bo-zon/LM3886-Hi-Fi-amplifier/docs/intedratS_018-ldsound.ru-2.jpg

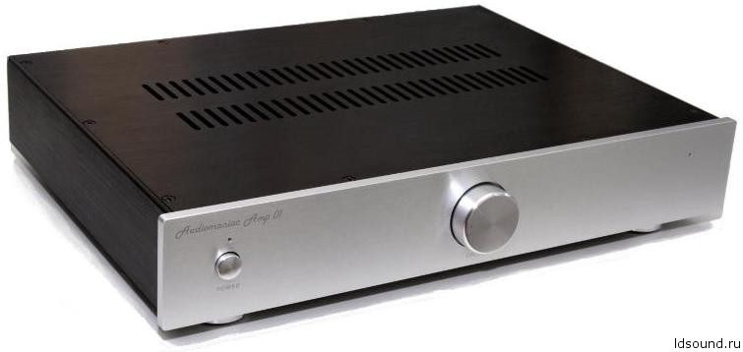
docs/intedratS_018-ldsound.ru-2.jpg
