bo-zon/LM3886-Hi-Fi-amplifier/docs/IMG_0611.jpg

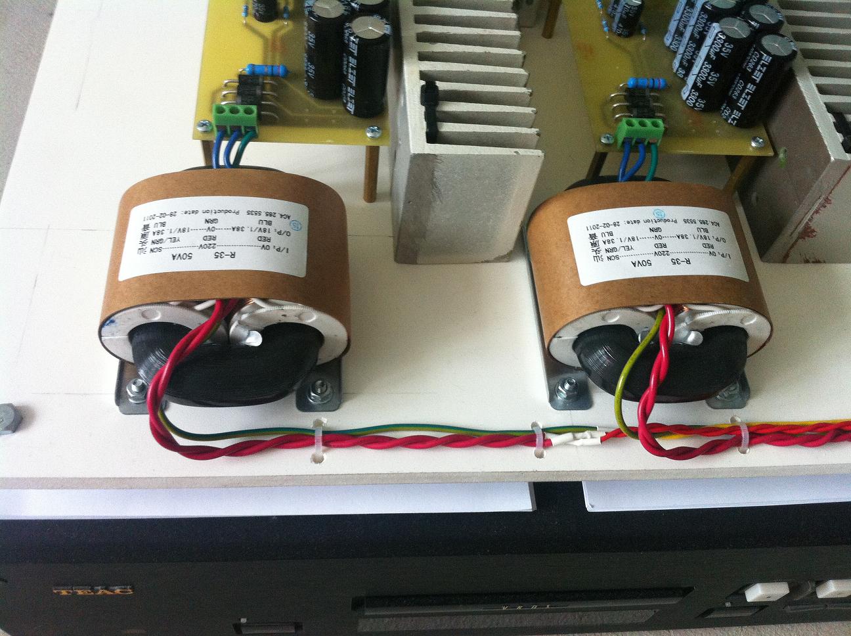
docs/IMG_0611.jpg
