bo-zon/LM3886-Hi-Fi-amplifier/docs/intedratS_018-ldsound.ru-21.png

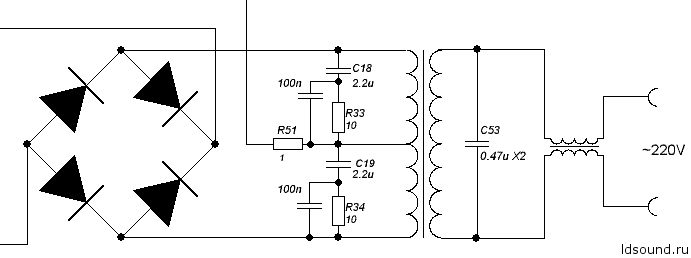
docs/intedratS_018-ldsound.ru-21.png
