bo-zon/LM3886-Hi-Fi-amplifier/docs/kit1.jpg

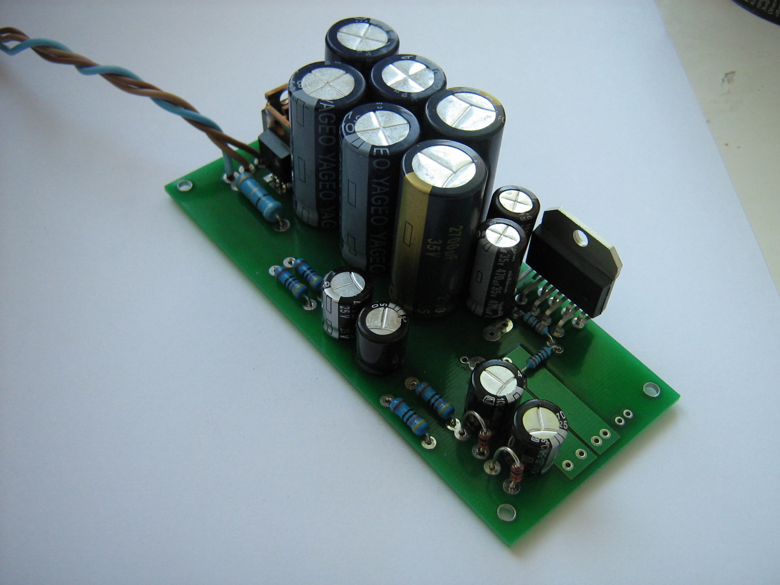
docs/kit1.jpg
