bo-zon/LM3886-Hi-Fi-amplifier/docs/snubber-tweak.GIF

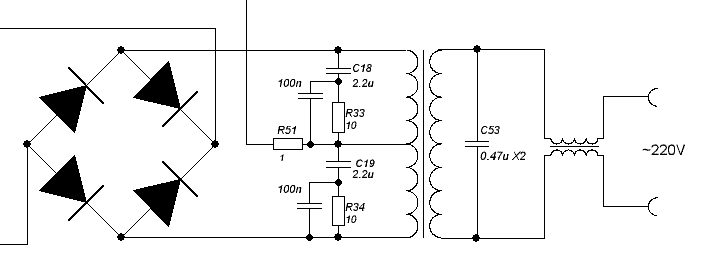
docs/snubber-tweak.GIF
