bo-zon/LM3886-Hi-Fi-amplifier/pcb/zd50.pdf

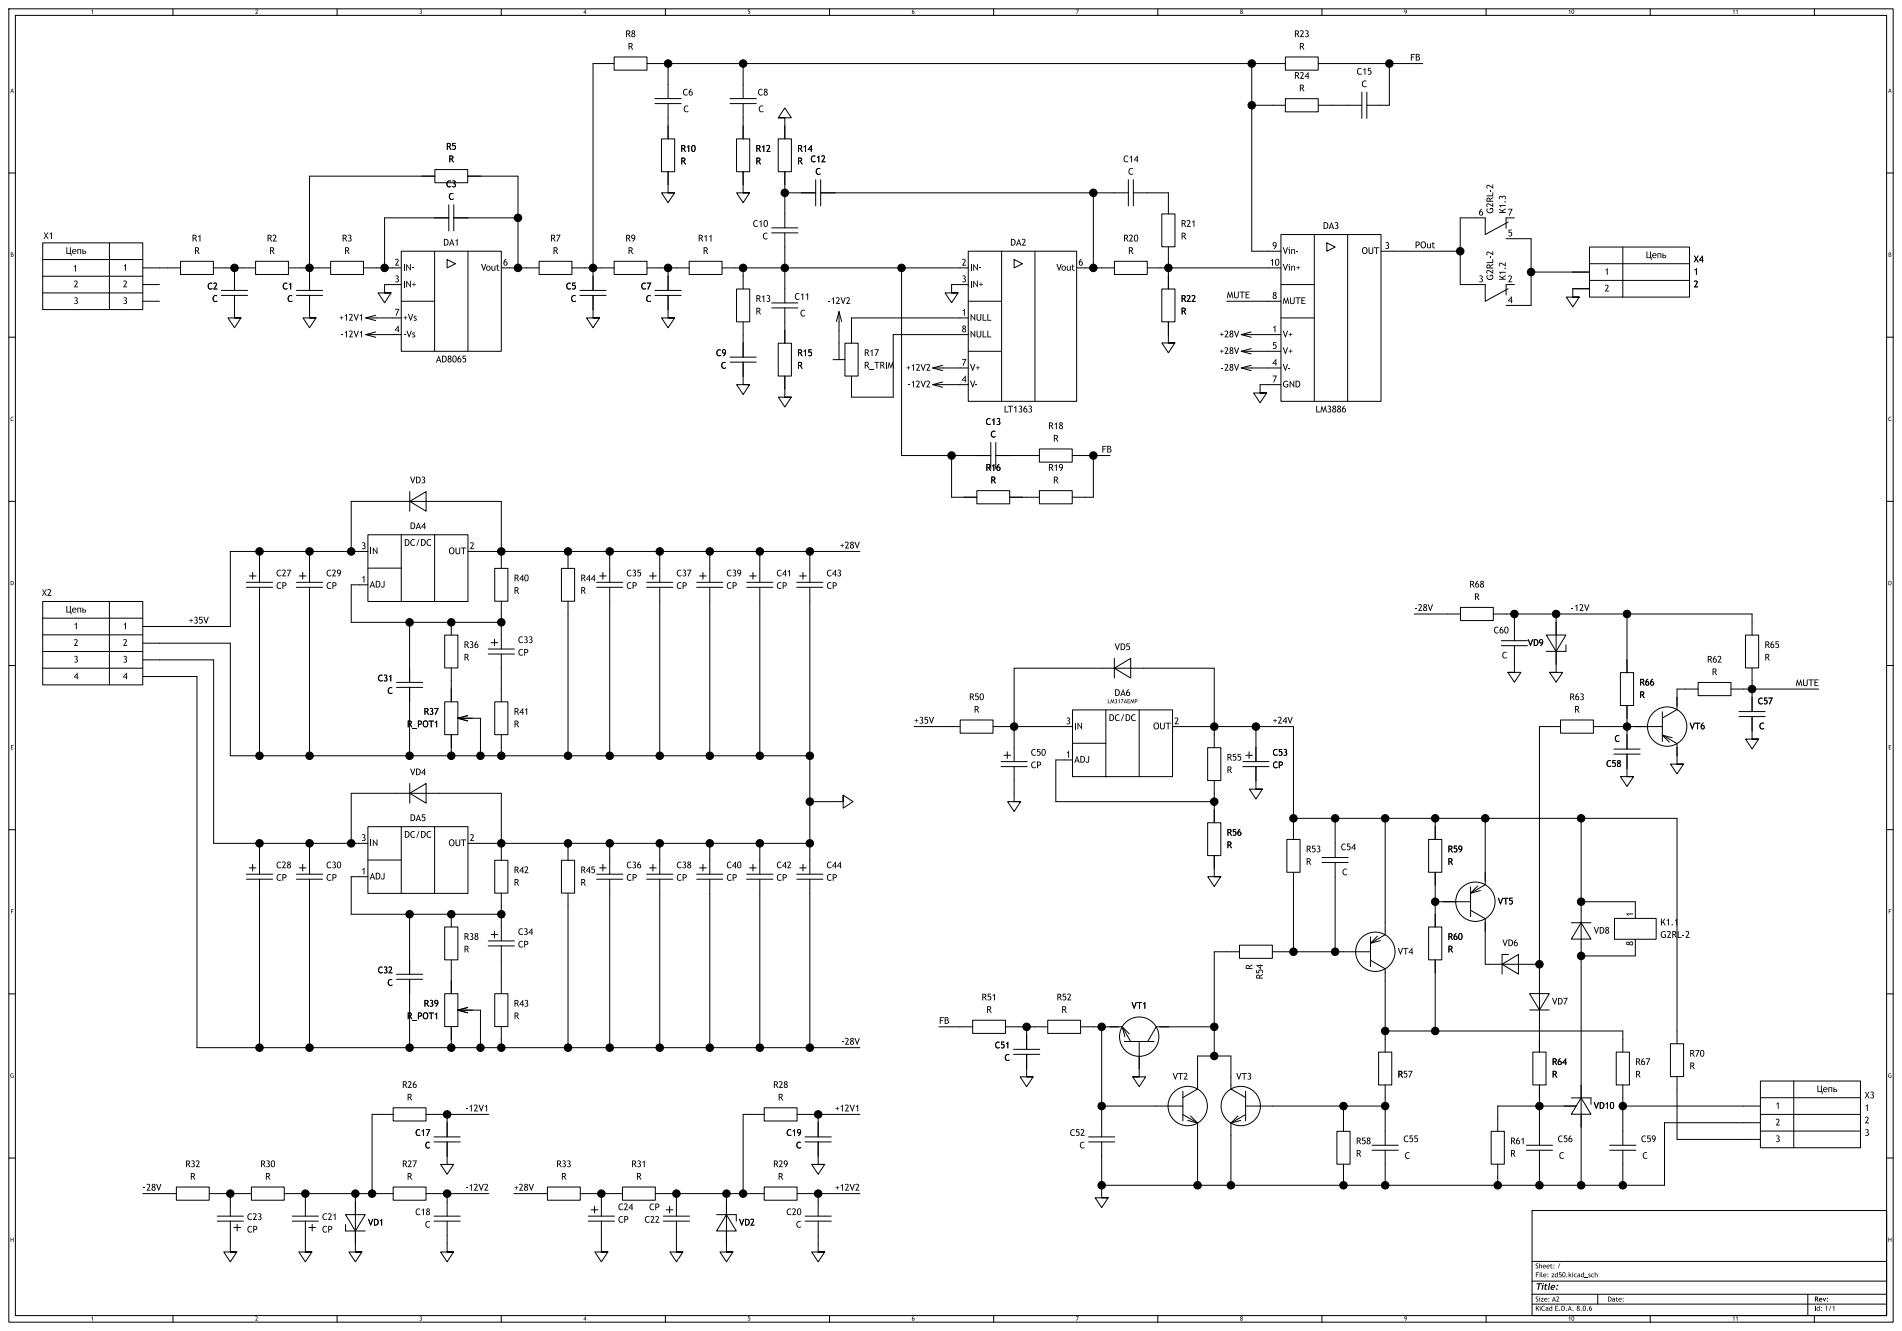
[picture p10: page 1]

Id: 1/1 Title: File: zd50.kicad_sch Sheet: /
