bo-zon/LM3886-Hi-Fi-amplifier/docs/romanoff-sch.pdf

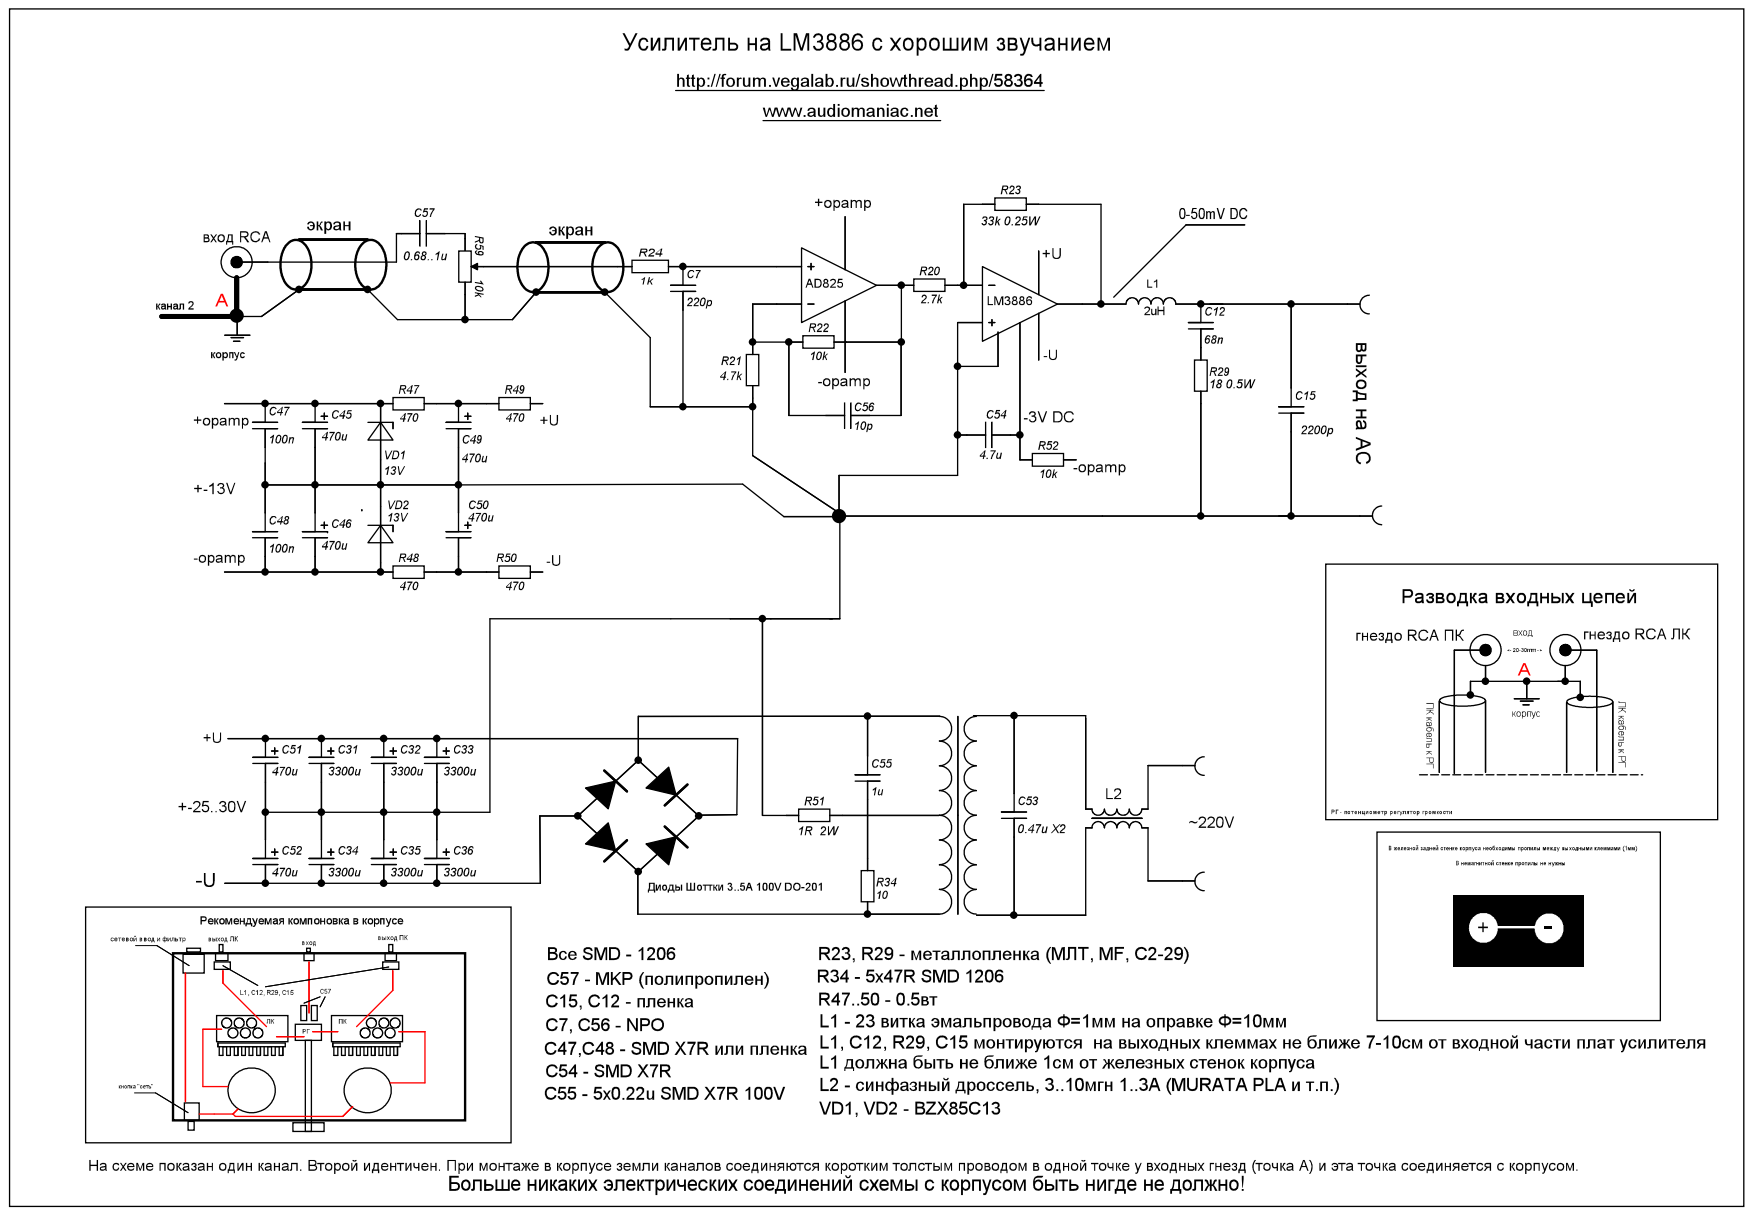
[picture p11: page 1]
