bo-zon/LM3886-Hi-Fi-amplifier/pcb/zd50.kicad_pcb

## KiCad design pcb/zd50.kicad_pcb (2025-01-15)

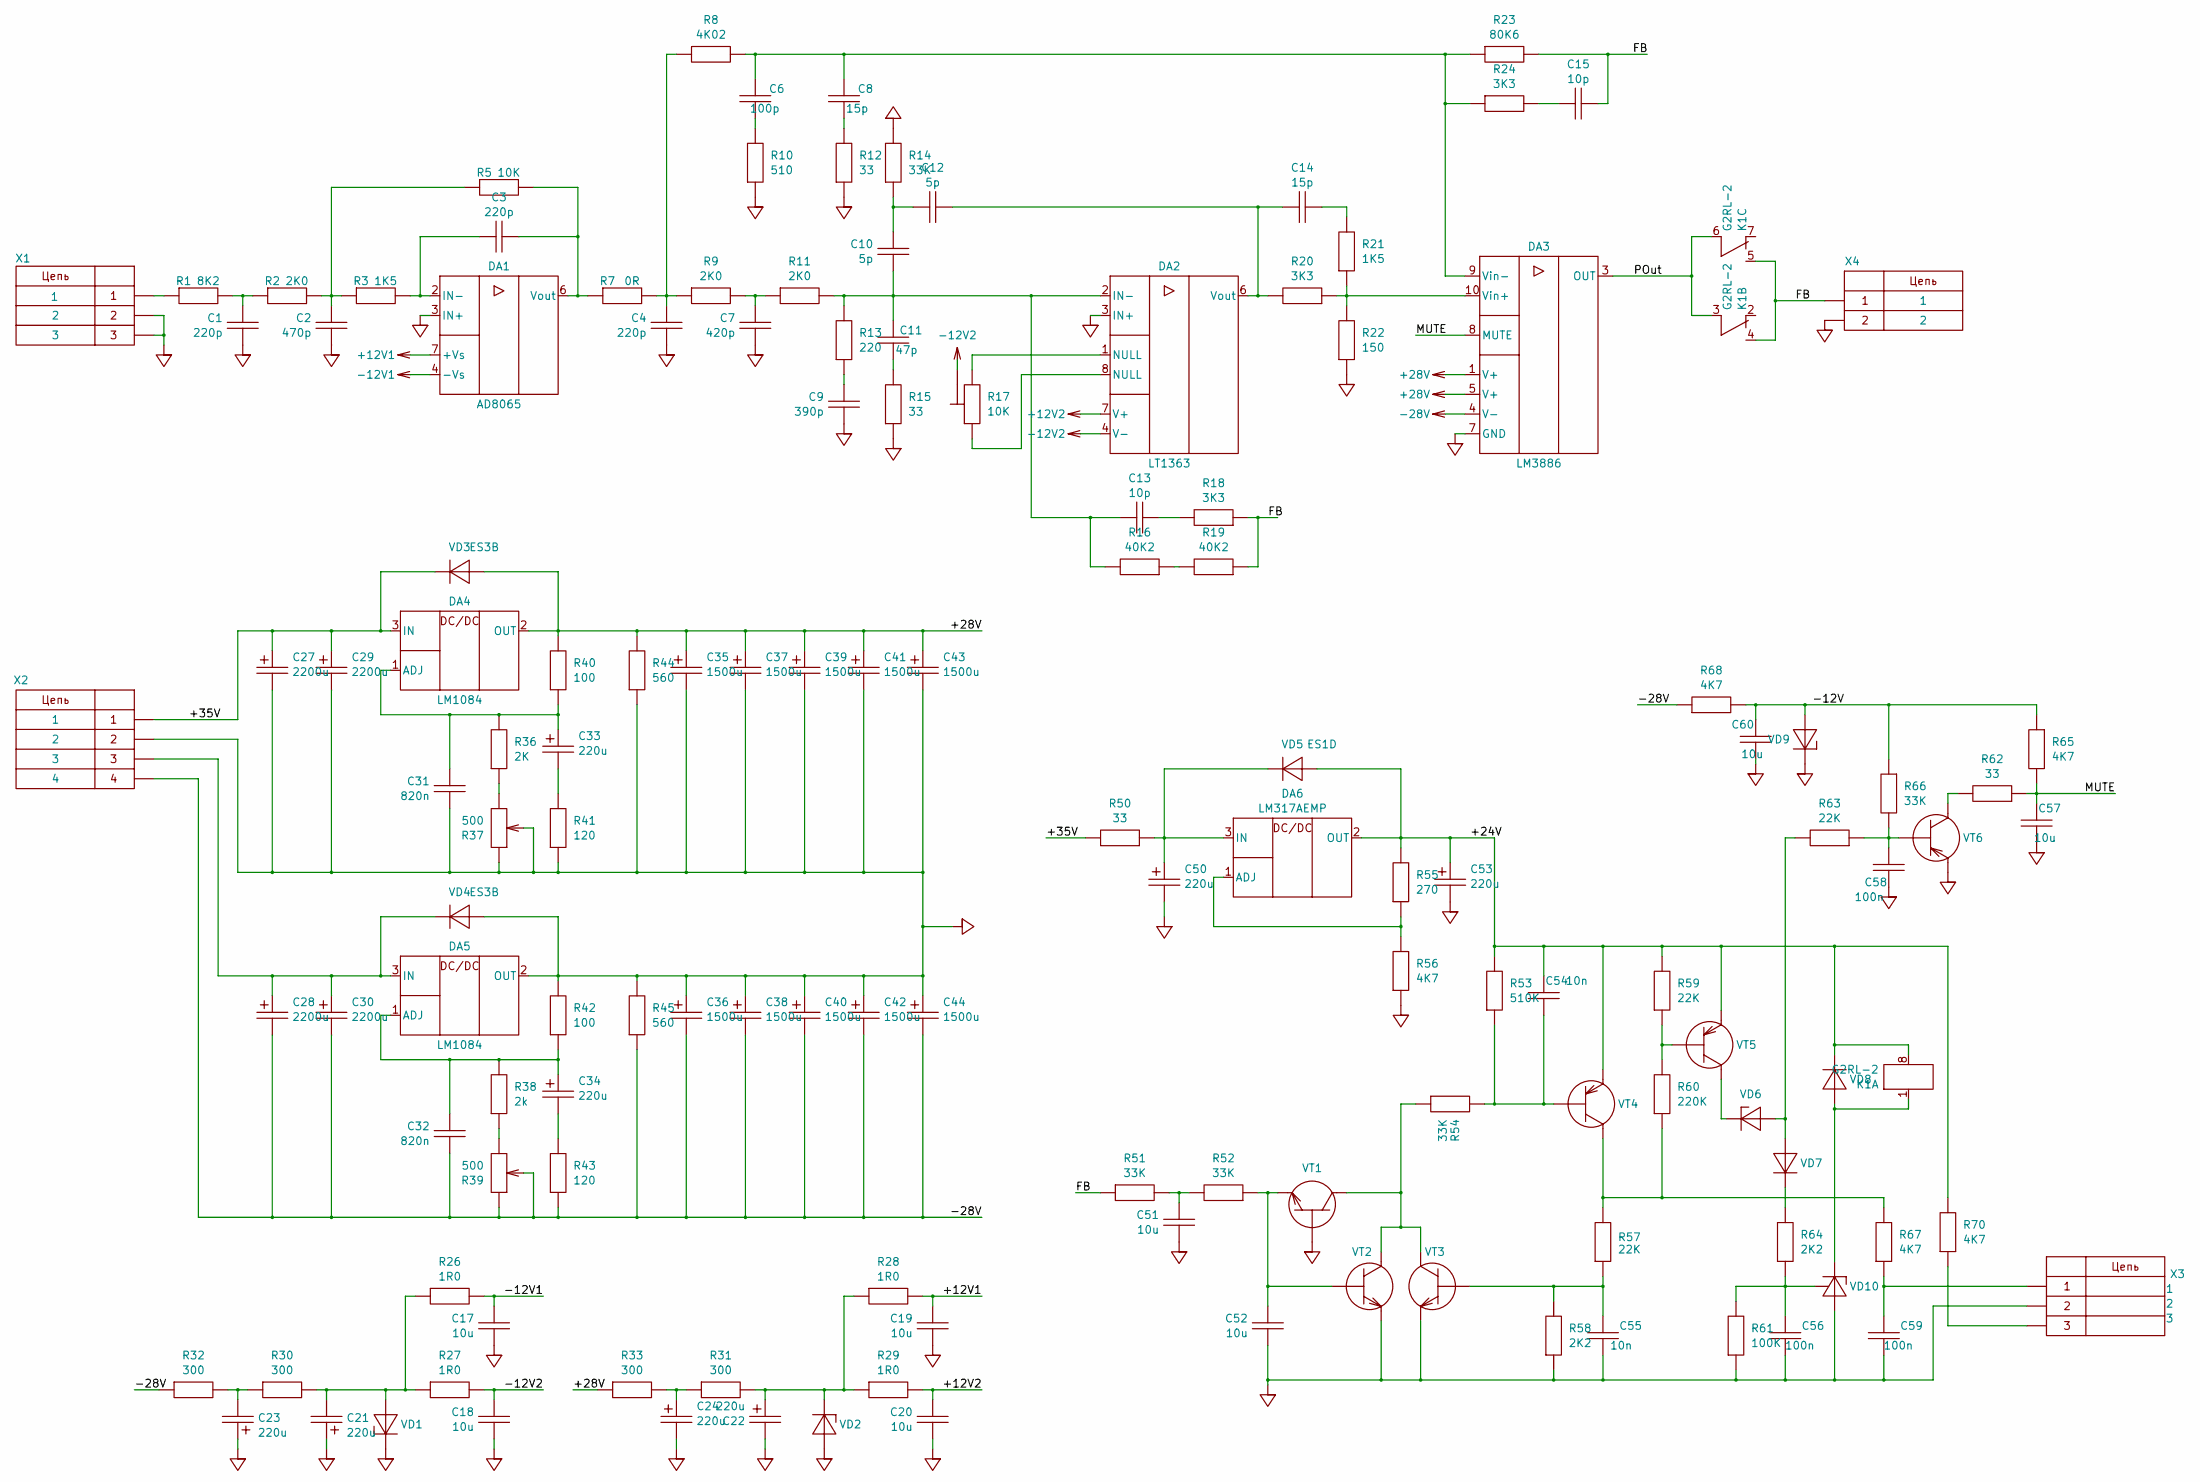
[picture p12: schematic zd50.kicad_sch]

Parts:
C1, C3, C4: 220p; C_0805_2012Metric
C2: 470p; C_0805_2012Metric
C6: 100p; C_0805_2012Metric
C7: 420p; C_0805_2012Metric
C8, C14: 15p; C_0805_2012Metric
C9: 390p; C_0805_2012Metric
C10, C12: 5p; C_0805_2012Metric
C11: 47p; C_0805_2012Metric
C13, C15: 10p; C_0805_2012Metric
C17, C18, C19, C20, C51, C52, C57, C60: 10u; C_1206_3216Metric
C21, C22, C23, C24: 220u; CP_Elec_8x10.5
C27, C28, C29, C30: 2200u; CP_Radial_D18.0mm_P7.50mm
C31, C32: 820n; C_Rect_L7.2mm_W7.2mm_P5.00mm_FKS2_FKP2_MKS2_MKP2
C33, C34, C50, C53: 220u; CP_Elec_10x10.5
C35, C36, C37, C38, C39, C40, C41, C42, C43, C44: 1500u; CP_Radial_D12.5mm_P5.00mm
C54, C55: 10n; C_0805_2012Metric
C56, C58, C59: 100n; C_0805_2012Metric
DA1: AD8065; SOIC-8_3.9x4.9mm_P1.27mm
DA2: LT1363; SOIC-8_3.9x4.9mm_P1.27mm
DA3: LM3886; TO-220-11_P3.4x2.54mm_StaggerOdd_Lead5.84mm_TabUp
DA4, DA5: LM1084; TO-220-3_Horizontal_TabUp
DA6: LM317AEMP; SOT-223-3_TabPin2
K1: G2RL-2; Relay_DPDT_Omron_G2RL-2
R1: 8K2; R_0805_2012Metric
R2, R9, R11: 2K0; R_0805_2012Metric
R3, R21: 1K5; R_0805_2012Metric
R5: 10K; R_0805_2012Metric
R7: 0R; R_0805_2012Metric
R8: 4K02; R_0805_2012Metric
R10: 510; R_0805_2012Metric
R12, R15, R50, R62: 33; R_0805_2012Metric
R13: 220; R_0805_2012Metric
R14, R51, R52, R54, R66: 33K; R_0805_2012Metric
R16, R19: 40K2; R_0805_2012Metric
R17: 10K; Potentiometer_Bourns_3314G_Vertical
R18, R20, R24: 3K3; R_0805_2012Metric
R22: 150; R_0805_2012Metric
R23: 80K6; R_0805_2012Metric
R26, R27, R28, R29: 1R0; R_0805_2012Metric
R30, R31, R32, R33: 300; R_1210_3225Metric
R36: 2K; R_2512_6332Metric
R37, R39: 500; Potentiometer_Bourns_3314G_Vertical
R38: 2k; R_2512_6332Metric
R40, R42: 100; R_0805_2012Metric
R41, R43: 120; R_0805_2012Metric
R44, R45: 560; R_Axial_DIN0414_L11.9mm_D4.5mm_P15.24mm_Horizontal
R53: 510K; R_0805_2012Metric
R55: 270; R_0805_2012Metric
R56, R65, R67, R68, R70: 4K7; R_0805_2012Metric
R57, R59, R63: 22K; R_0805_2012Metric
R58, R64: 2K2; R_0805_2012Metric
R60: 220K; R_0805_2012Metric
R61: 100K; R_0805_2012Metric
VD1, VD2, VD9: FLZ12V; D_MiniMELF
VD3, VD4: ES3B; D_SMB
VD5, VD8: ES1D; D_SMA
VD6: MMBTA56; D_MiniMELF
VD7: DL4148; D_MiniMELF
VD10: TL431; SOT-23-3
VT1, VT2, VT3: MMBTA06; SOT-23-3
VT4, VT5, VT6: MMBTA56; SOT-23-3
X1: CONN_3; SolderWire-0.5sqmm_1x03_P4.6mm_D0.9mm_OD2.1mm
X2: CONN_4; SolderWire-0.75sqmm_1x04_P7mm_D1.25mm_OD3.5mm
X3: CONN_3; SolderWire-0.25sqmm_1x03_P4.2mm_D0.65mm_OD1.7mm
X4: CONN_2; SolderWire-2sqmm_1x02_P7.8mm_D2mm_OD3.9mm

Connections:
+12V1: C19.1, DA1.7 (+Vs), R28.2
+12V2: C20.1, DA2.7 (V+), R29.2
+28V: C35.1, C37.1, C39.1, C41.1, C43.1, DA3.1 (V+), DA3.5 (V+), DA4.2 (OUT), R33.1, R40.2, R44.2, VD3.2 (A)
-12V1: C17.1, DA1.4 (-Vs), R26.2
-12V2: C18.1, DA2.4 (V-), R17.2, R27.2
-28V: C28.2, C30.2, C32.2, C36.2, C38.2, C40.2, C42.2, C44.2, DA3.4 (V-), R32.1, R39.1, R39.2, R43.1, R45.1, R68.1, X2.4
/+24V: C53.1, C54.1, DA6.2 (OUT), K1.8, R53.2, R55.2, R59.2, R70.2, VD5.2 (A), VD8.1 (K), VT4.2 (E), VT5.2 (E)
/+35V: C27.1, C29.1, DA4.3 (IN), R50.2, VD3.1 (K), X2.1
/-12V: C60.1, R65.1, R66.1, R68.2, VD9.2 (A)
/FB: C15.2, K1.4, K1.5, R18.1, R19.1, R23.2, R51.1, X4.1
/MUTE: C57.1, DA3.8 (MUTE), R62.1, R65.2
/POut: DA3.3 (OUT), K1.3, K1.6
GND: C1.2, C2.2, C4.2, C7.2, C9.2, C17.2, C18.2, C19.2, C20.2, C21.1, C22.2, C23.1, C24.2, C27.2, C29.2, C31.2, C35.2, C36.1, C37.2, C38.1, C39.2, C40.1, C41.2, C42.1, C43.2, C44.1, C50.2, C51.2, C52.2, C53.2, C55.2, C56.2, C57.2, C58.1, C59.2, C60.2, DA1.3 (IN+), DA2.3 (IN+), DA3.7 (GND), DA5.2 (OUT), R10.1, R12.1, R14.2, R15.1, R22.1, R37.1, R37.2, R41.1, R42.2, R44.1, R45.2, R56.1, R58.1, R61.1, VD1.1 (K), VD2.2 (A), VD4.2 (A), VD9.1 (K), VD10.3 (A), VT1.1 (B), VT2.2 (E), VT3.2 (E), VT6.2 (E), X1.2, X1.3, X2.2, X3.2, X4.2
unnamed: C1.1, R1.2, R2.1
unnamed: C2.1, R2.2, R3.1, R5.1
unnamed: C4.1, R7.2, R8.1, R9.1
unnamed: C6.2, R10.2
unnamed: C7.1, R9.2, R11.1
unnamed: C8.2, R12.2
unnamed: C9.1, R13.1
unnamed: C10.1, C12.1, R14.1
unnamed: C11.2, R15.2
unnamed: C13.2, R18.2
unnamed: C14.2, R21.2
unnamed: C15.1, R24.2
unnamed: C23.2, R30.1, R32.2
unnamed: C24.1, R31.1, R33.2
unnamed: C33.2, R41.2
unnamed: C34.2, R43.2
unnamed: C51.1, R51.2, R52.2
unnamed: C59.1, R67.1, X3.1
unnamed: C3.1, DA1.2 (IN-), R3.2
unnamed: C3.2, DA1.6 (Vout), R5.2, R7.1
unnamed: C10.2, C11.1, C13.1, DA2.2 (IN-), R11.2, R13.2, R16.2
unnamed: DA2.1 (NULL), R17.3
unnamed: DA2.8 (NULL), R17.1
unnamed: C12.2, C14.1, DA2.6 (Vout), R20.2
unnamed: DA3.10 (Vin+), R20.1, R21.1, R22.2
unnamed: C6.1, C8.1, DA3.9 (Vin-), R8.2, R23.1, R24.1
unnamed: C31.1, C33.1, DA4.1 (ADJ), R36.2, R40.1
unnamed: C32.1, C34.1, DA5.1 (ADJ), R38.2, R42.1
unnamed: C28.1, C30.1, DA5.3 (IN), VD4.1 (K), X2.3
unnamed: DA6.1 (ADJ), R55.1, R56.2
unnamed: C50.1, DA6.3 (IN), R50.1, VD5.1 (K)
unnamed: R1.1, X1.1
unnamed: R16.1, R19.2
unnamed: R36.1, R37.3
unnamed: R38.1, R39.3
unnamed: R70.1, X3.3
unnamed: C21.2, R26.1, R27.1, R30.2, VD1.2 (A)
unnamed: C22.1, R28.1, R29.1, R31.2, VD2.1 (K)
unnamed: R63.2, VD6.2 (A), VD7.2 (A)
unnamed: VD6.1 (K), VT5.3 (C)
unnamed: R64.2, VD7.1 (K)
unnamed: K1.1, VD8.2 (A), VD10.1 (K)
unnamed: C56.1, R61.2, R64.1, VD10.2 (REF)
unnamed: R54.1, VT1.3 (C), VT2.3 (C), VT3.3 (C)
unnamed: C52.1, R52.1, VT1.2 (E), VT2.1 (B)
unnamed: C55.1, R57.1, R58.2, VT3.1 (B)
unnamed: C54.2, R53.1, R54.2, VT4.1 (B)
unnamed: R57.2, R60.1, R67.2, VT4.3 (C)
unnamed: R59.1, R60.2, VT5.1 (B)
unnamed: C58.2, R63.1, R66.2, VT6.1 (B)
unnamed: R62.2, VT6.3 (C)

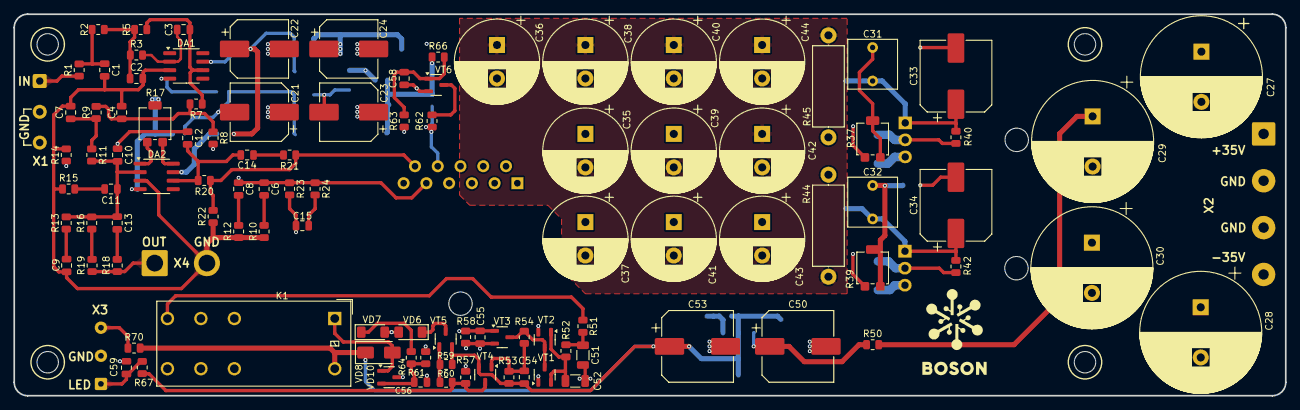
[picture p13: board zd50.kicad_pcb from above]

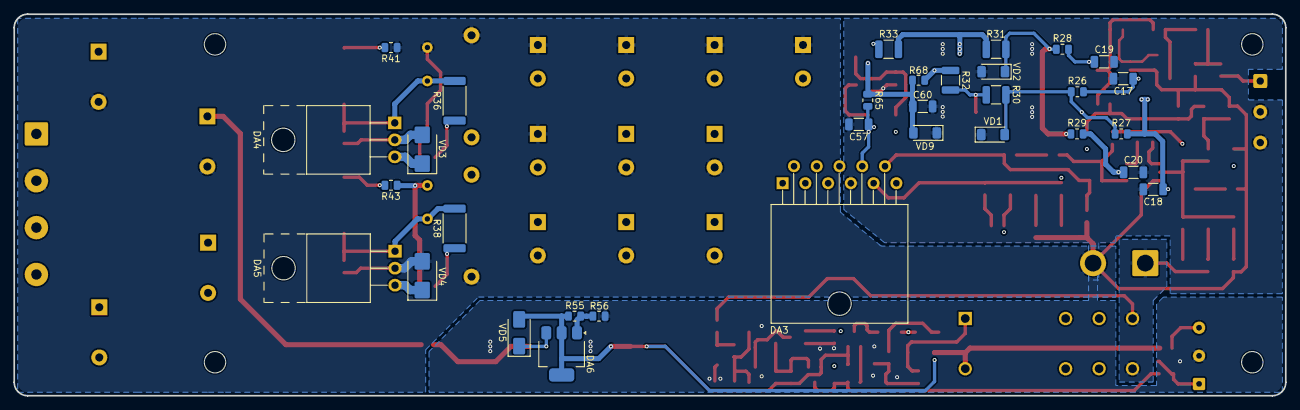
[picture p14: board zd50.kicad_pcb from below]

Board: 4 copper layers, 190.0 x 57.0 mm, 142 parts (32 on the bottom side), 64 nets.

Other parts of the board:
MH1, MH2, MH3, MH4: MountingHole_3.2mm_M3
